corgiolu-labs/ded-powder-flow-sensor/docs/presentation.pdf

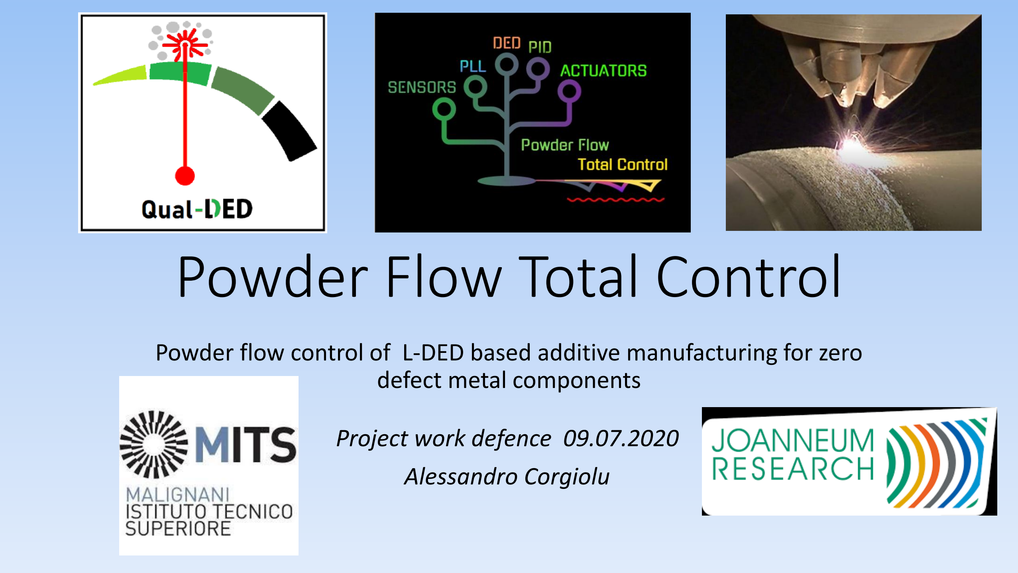
[picture p58: page 1]

# Powder Flow Total Control

Powder flow control of L-DED based additive manufacturing for zero defect metal components

Project work defence 09.07.2020 Alessandro Corgiolu

# Summary

- What is a DED system
- How it Works
- The 6 axis robot arm ABB IRB 4600
- The Laser head (3-6)KW
- The Powder feeder (5-50) g/min
- First attempt to powder detection (August - September 2019 Erasmus+)
- Inductance meter
- Frequency meter
- Superetherodyne stabilized frequency meter (first attempt)
- Second attempt to powder detection (February - April 2020 Internship)
- State of art of powder flow measurement systems
- Light absorption/scattering method
- Super heterodyne method (second attempt)
- Beat (acoustics) method
- Closed Loop Control
- Arduino MKR 1010 like control system

## What is a DED system?

## What is a DED system Laser cladding

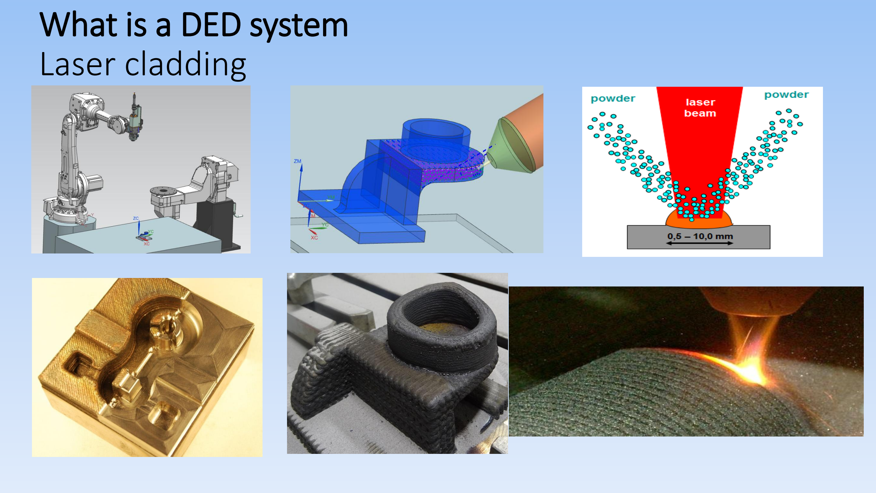
[picture p59: page 4]

# Robot arm ABB IRB 4600

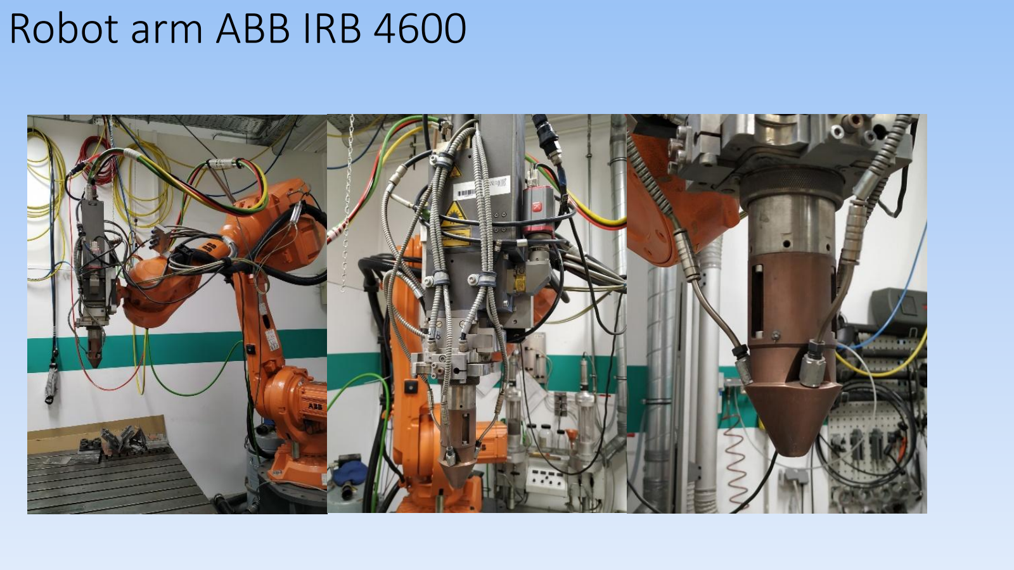
[picture p60: page 5]

## Laser head

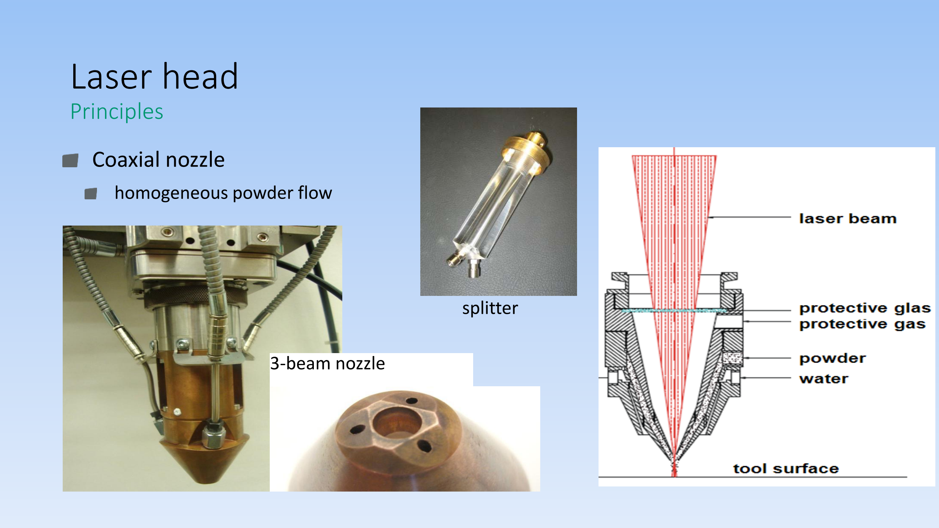
[picture p61: page 6]

Coaxial nozzle

homogeneous powder flow

3-beam nozzle

splitter

Principles

## Powder feeder

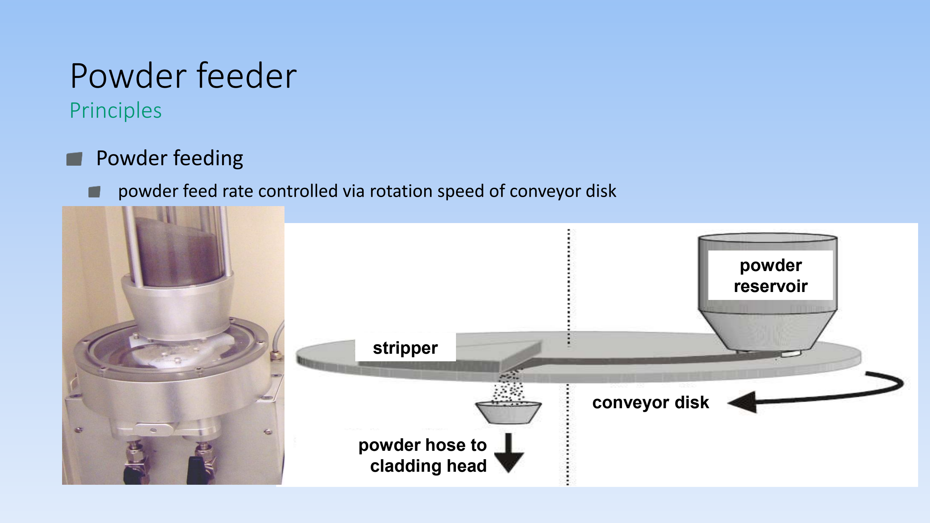
[picture p62: page 7]

Powder feeding

powder feed rate controlled via rotation speed of conveyor disk

powder hose to
cladding head

conveyor disk

powder
reservoir

stripper

Principles

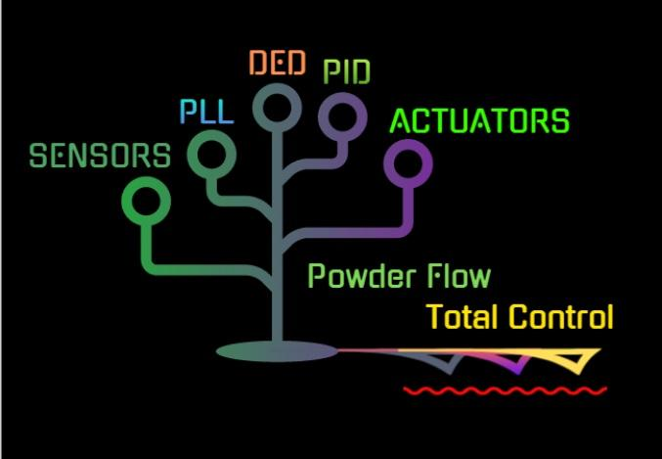
[picture p63: figure]

# Powder Flow Total Control

Powder flow control of L-DED based additive manufacturing for zero defect metal components

# First attempt to powder detection (August -September 2019 Erasmus+)

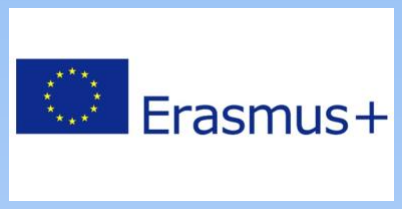
[picture p64: figure]

In August 2019 I was in charge of studying the possible principles for detecting and measure the flow of dust through the machine.

## Input data:

- Powder flow rate between 2.5– 50 g/min
- Granulometry powder between 45 – 105µm
- Argon gas flow at 5 l/min
- Almost always the material is metallic

# Firsts attempts to powder detection (August -September 2019 Erasmus+)

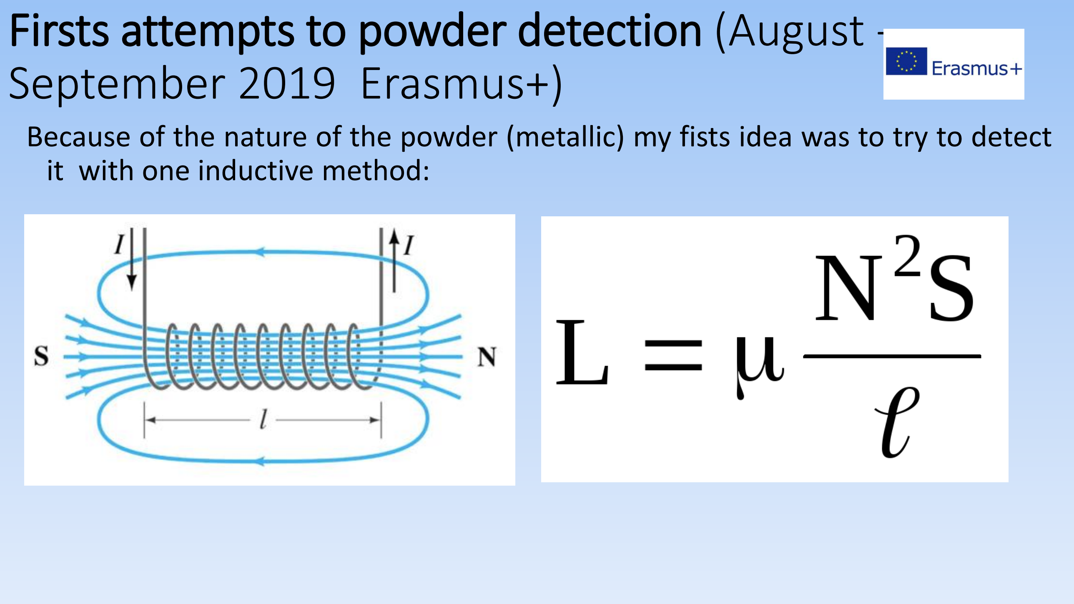
[picture p65: page 10]

Because of the nature of the powder (metallic) my fists idea was to try to detect it with one inductive method:

# First attempt to powder detection (August -September 2019 Erasmus+)

The solenoid formula shows that the self-induction coefficient L of the solenoid is proportional to the following physical quantities:
- µ : magnetic permeability of the solenoid core [H/m]
- N: number of turns
- S: solenoid cross-section area [m]
- l: solenoid length [m]

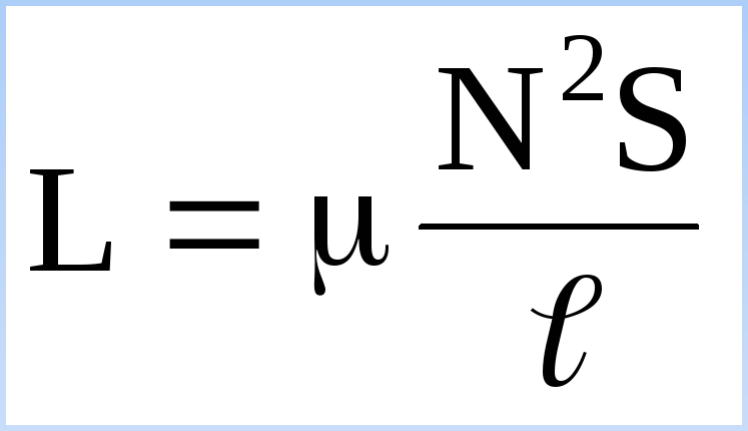
[picture p66: figure]

if the mechanical measurements of the solenoid are fixed, (N S l = cost) the variation of the self-induction coefficient L is proportional on the variation of the permeability of the core µ contained by the solenoid.

# Firsts attempts to powder detection (August -September 2019 Erasmus+)

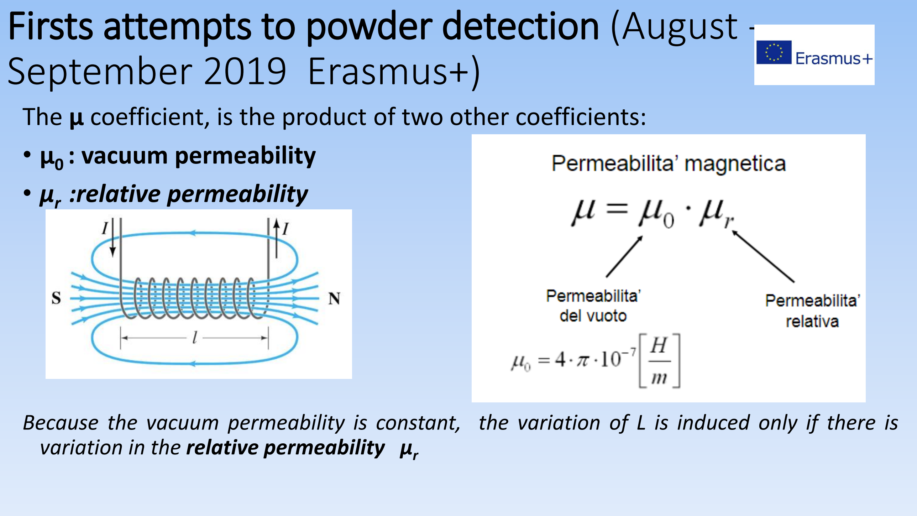
[picture p67: page 12]

The µ coefficient, is the product of two other coefficients:
- µ0

### : vacuum permeability

- µr
:relative permeability

Because the vacuum permeability is constant, the variation of L is induced only if there is variation in the relative permeability µr

# First attempt to powder detection (August -September 2019 Erasmus+)

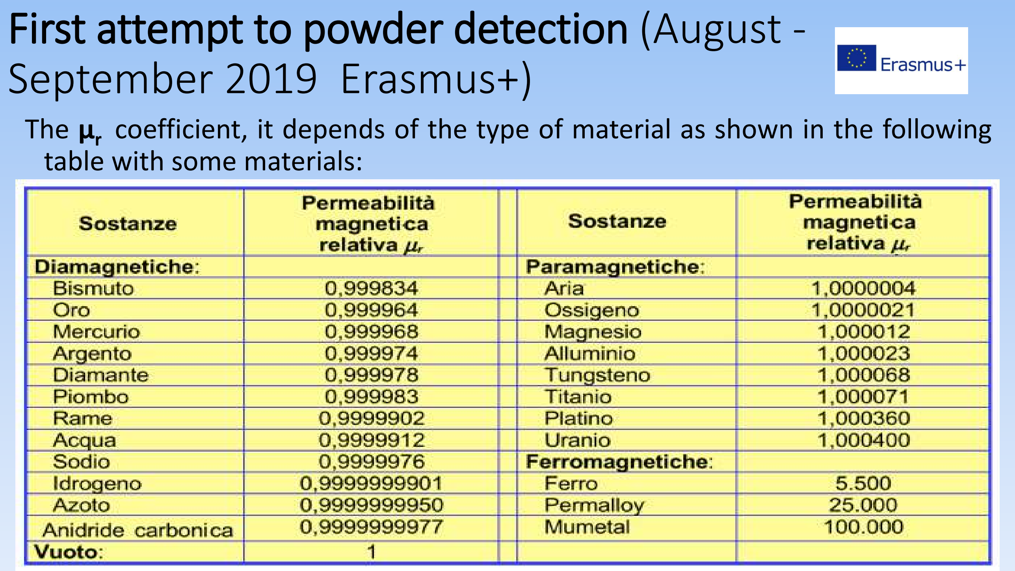
[picture p68: page 13]

The µr
coefficient, it depends of the type of material as shown in the following table with some materials:

# First attempt to powder detection (August -September 2019 Erasmus+)

- If we imagine that the core inside the solenoid is made up of a heterogeneous mixture of metal dust and gas e.g. argon, it is theoretically possible to obtain a variation of the self-induction coefficient L because the total magnetic permeability coefficient of the volume contained inside the solenoid varies.

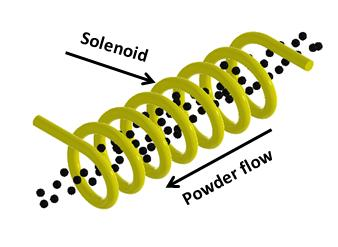
[picture p69: figure]

On the basis of this fact it can be demonstrated that each variation in the mass flow of dust contained within the solenoid “variable core”, corresponds to a variation in the self-induction coefficient L.

# First attempt to powder detection (August -September 2019 Erasmus+)

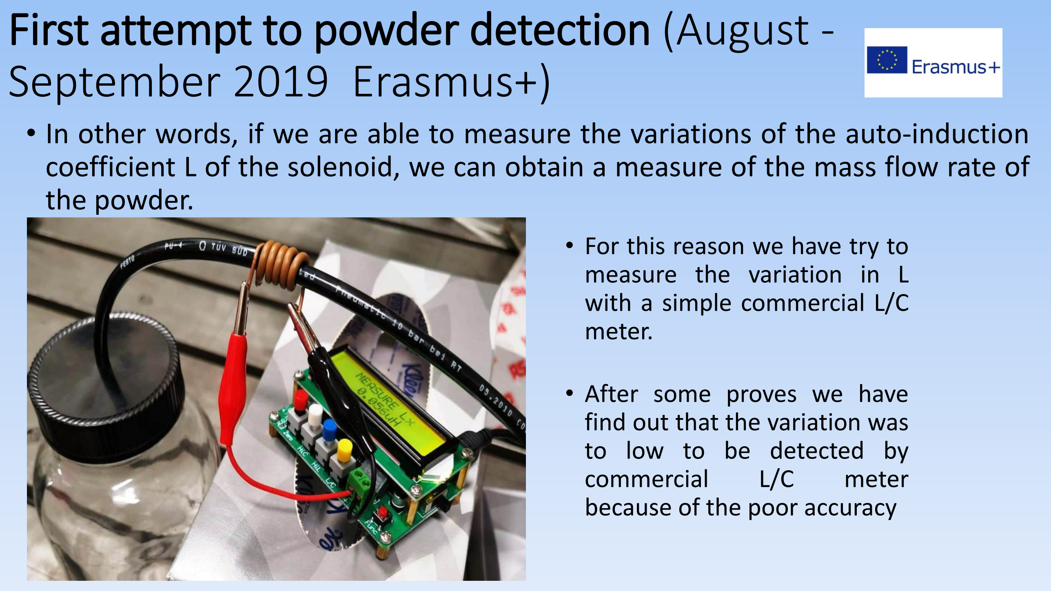
[picture p70: page 15]

- In other words, if we are able to measure the variations of the auto-induction coefficient L of the solenoid, we can obtain a measure of the mass flow rate of the powder.
- For this reason we have try to measure the variation in L with a simple commercial L/C meter.
- After some proves we have find out that the variation was to low to be detected by
commercial | L/C | meter
because of the poor accuracy

# First attempt to powder detection (August -September 2019 Erasmus+)

- Studying the schematic of the commercial instrument we have find out that the measure of the L was performed by a circuit that using the solenoid L and a capacitor of known value C, is able to measure the frequency of oscillation of the group L/C, in accordance with the following formula:

In other words if we can
measure the frequency of the group Lx/C we can estimate the variation of the Lx

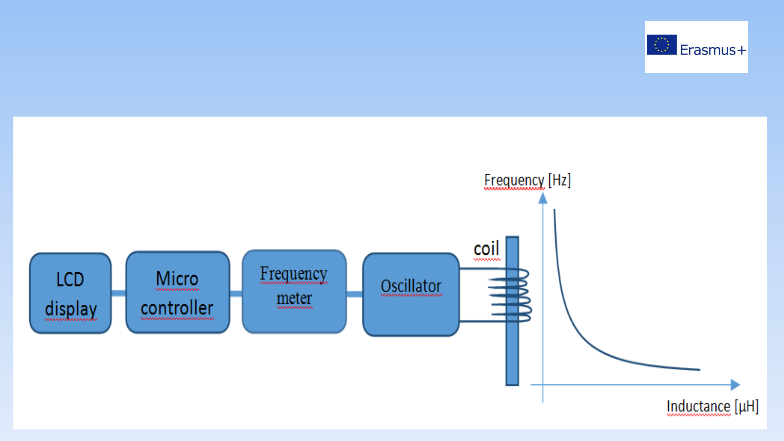
[picture p71: page 17]
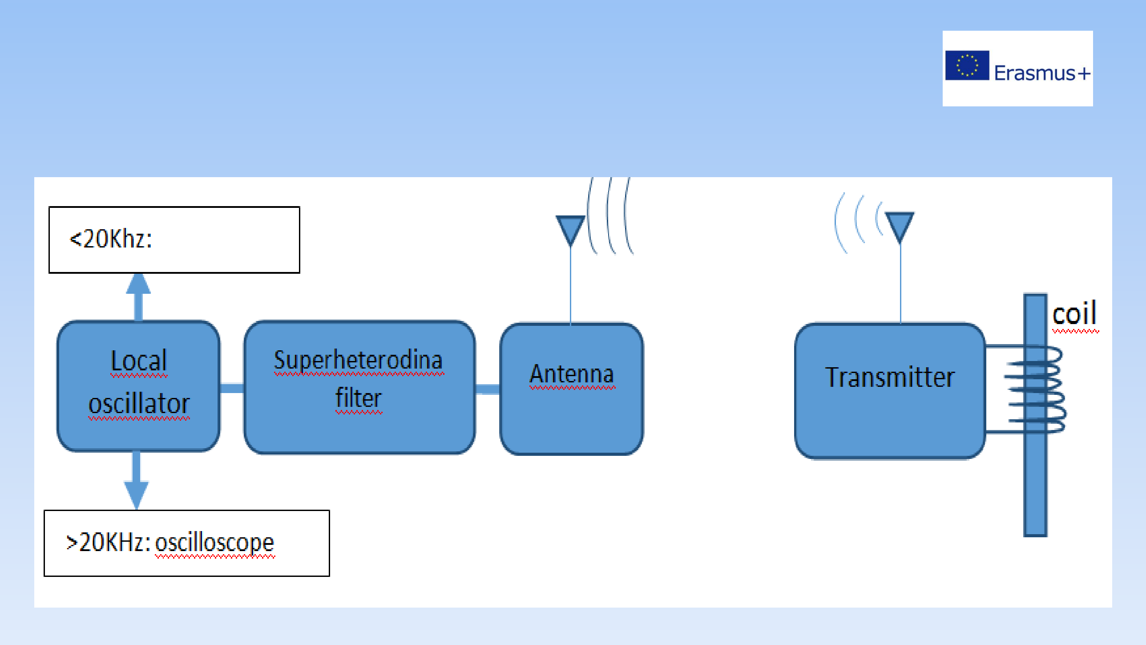
[picture p72: page 18]
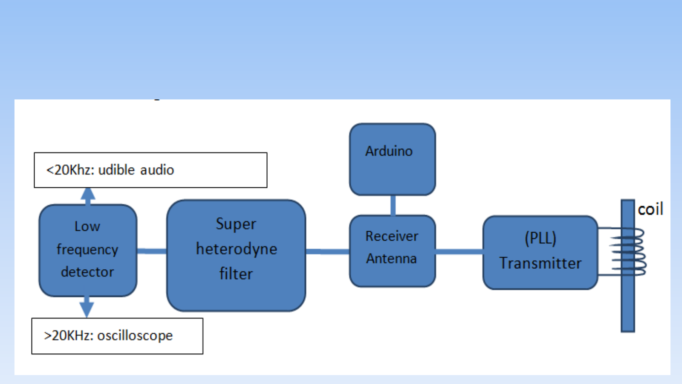
[picture p73: page 19]
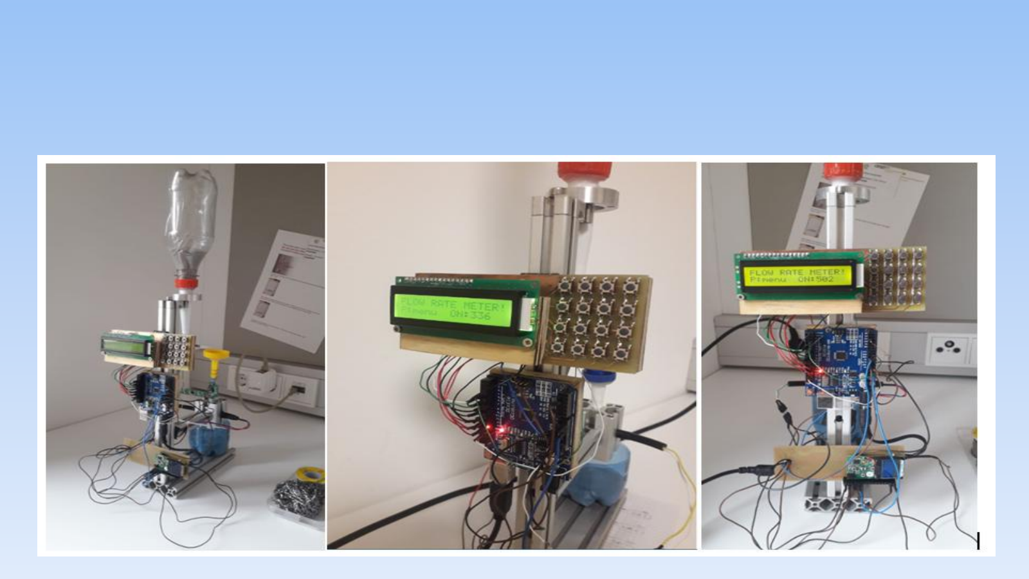
[picture p74: page 20]
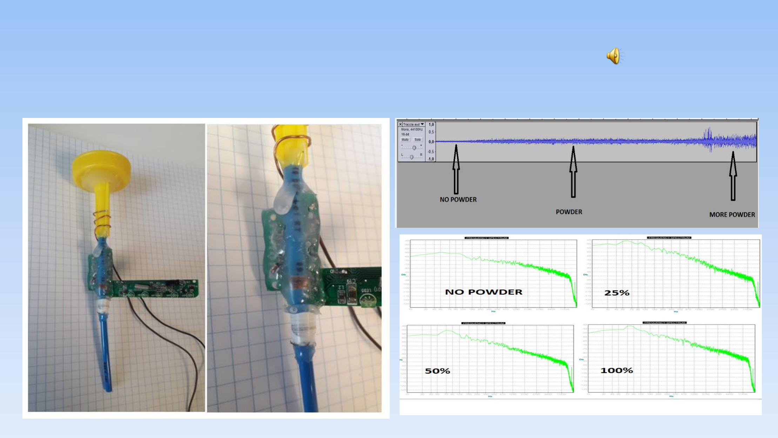
[picture p75: page 21]

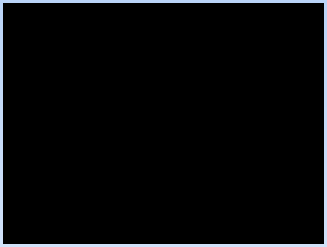
[picture p76: figure]
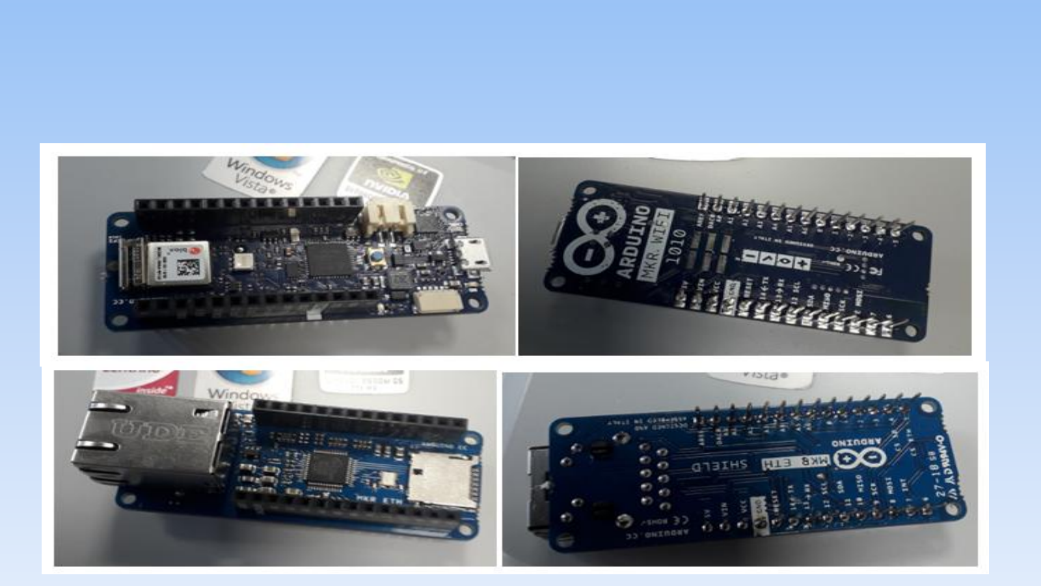
[picture p77: page 23]

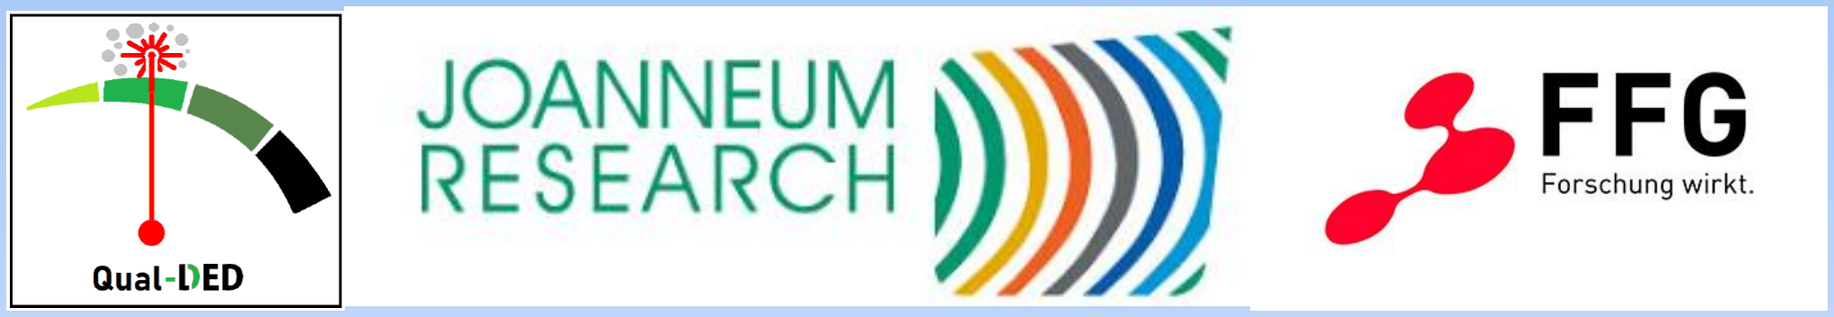
[picture p78: figure]

This work has been done in the framework of the QuaL-DED: Total control of laser-based additive manufacturing for zero defect metal components. This project is funded by the Austrian Research Funding Agency (FFG), under the grant number 877386, within the
32. Call of the Factories of the Future (Producktion der Zukunft 32 AS).
