corgiolu-labs/ded-powder-flow-sensor/(commit log)

2026-06-18 Initial commit — in-situ powder-flow sensor for metal DED (research overview)
    Research internship at Joanneum Research (2019-2020): system concept, RF inductance / super-heterodyne sensor (PWD sensor PCB), benchtop prototype with Arduino MKR closed-loop control. My own account and design artifacts only — no consortium deliverable, partner names or third-party material.
2026-06-18 Add prototype demo video (compressed, audio-stripped) and inline GIF
    docs/video/prototype-demo.mp4 (600x1066, no audio, 85s) + docs/images/prototype-demo.gif; README prototype section now shows the powder being metered through the sensor.
2026-06-18 Add Arduino firmware, sensor schematics/PCB and the DED robot-cell photo
    firmware/: complete sketch (LCD+keypad menu, material select, PID setpoint, PWM vibrator, photodiode). hardware/schematics/: heterodyne sensor circuit (theremin-derived) + PCB placement. docs/images/: DED robot cell (Joanneum, with permission) + sensor on the tube. README: new Schematics & firmware section, robot photo, repository layout.
    [getgrams.h, lcd.h, lcdkeypad.h, numerickeypad.h, powder_flow_controller.ino]
2026-06-18 Rewrite from the ITS final report: real results, correct framing, acknowledgement
    Source of truth = my ITS Malignani final report. Add the validated magneto-acoustic FFT result (peak tracks 25/50/100% flow) + the real test bench. Correct the robot (ABB IRB 4600 + 3-6kW Nd:YAG). Move the theremin-derived dual-oscillator to Future work (proposed next step, not tested). Add QuaL-DED / FFG acknowledgement (results remain Joanneum's, shared with permission).
2026-06-18 Enrich with real process/result images; name the realized oscillator (Colpitts)
    Add DED-in-action + printed part, a sharper ABB robot photo, the realized sensing chain (coil -> Colpitts oscillator -> freq meter -> MCU -> LCD), three validation results (signal amplitude, FFT peak shift, mass-flow vs inductance) and the optical-readout diagram (future work). Images selected from my ITS report + presentation.
2026-06-18 Correct the controller: the concept experiment ran on an Arduino UNO
    The realized benchtop experiment used an Arduino UNO; the connected Arduino MKR WiFi 1010 build (Modbus TCP, multi-channel comms, SD logging) was a planned next step.
2026-06-18 Future work: add a data-driven (ML) readout of the acoustic sensor
    Honest, specific framing: spectral features + a light regressor, validated per session; a smarter readout layer bounded by SNR and labelled data, not a way around the physics.
